aweijnitz/expressive-circuits-walkman-motor/assets/walkman_front-panel-deco-01.png

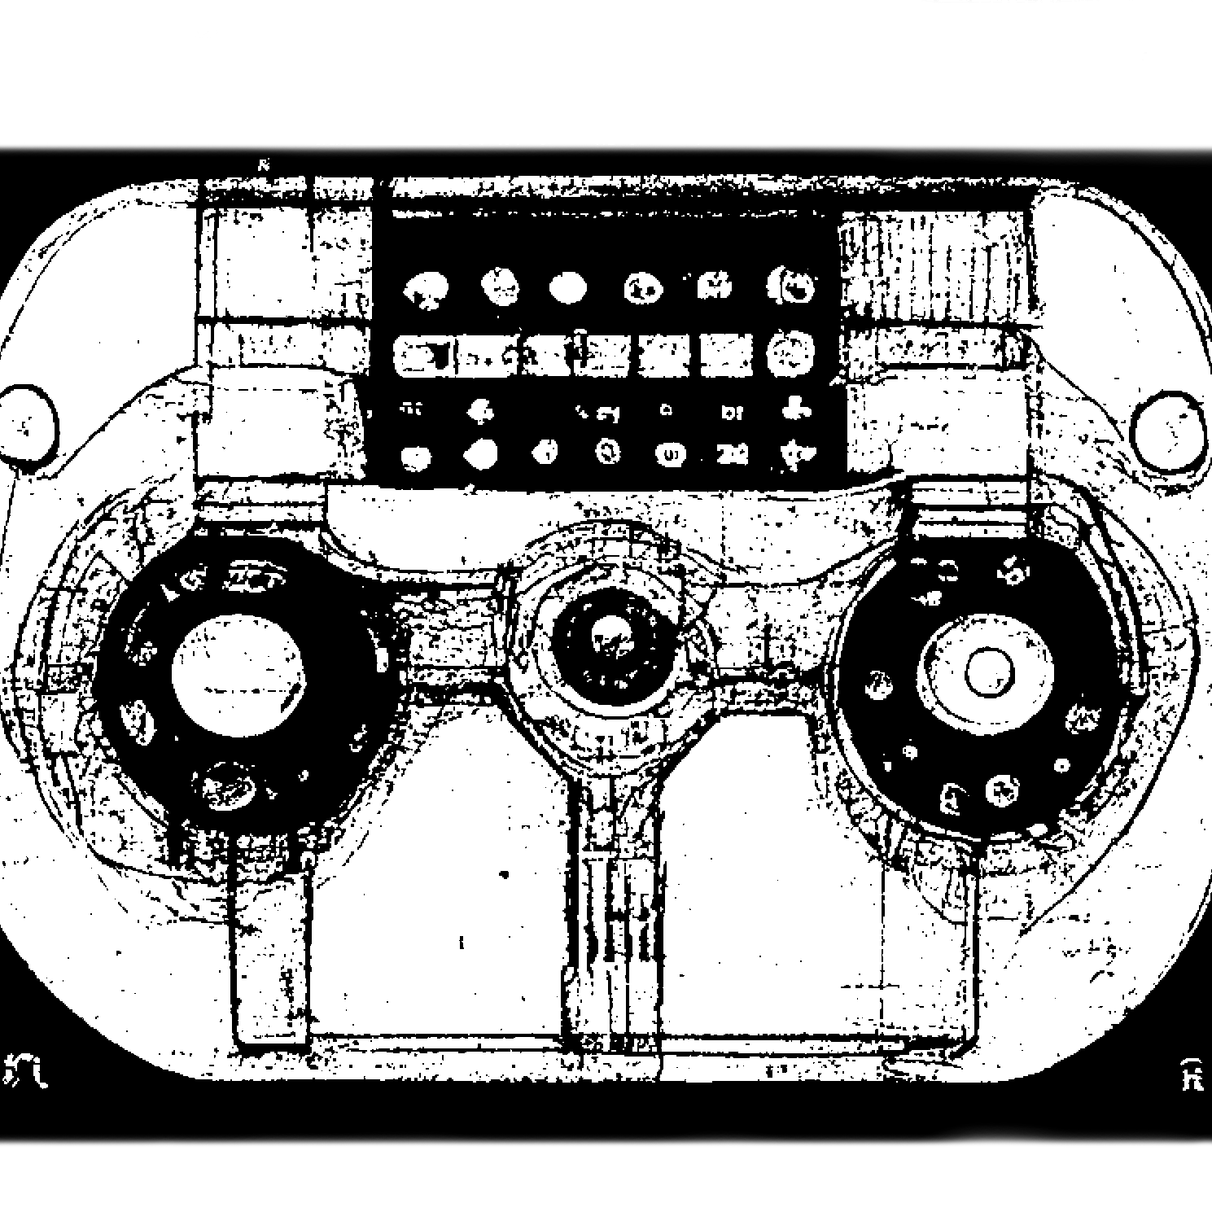
assets/walkman_front-panel-deco-01.png
