aweijnitz/expressive-circuits-walkman-motor/assets/walkman_front-panel-deco-MidJourney-export.png

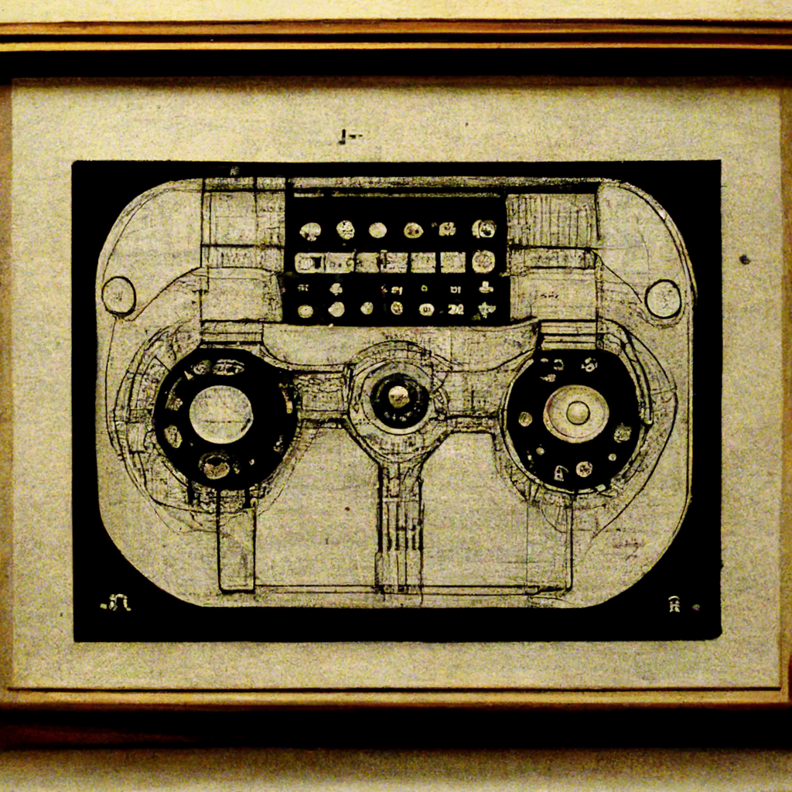
assets/walkman_front-panel-deco-MidJourney-export.png
