aweijnitz/expressive-circuits-walkman-motor/easyEDA-files/Schematic_WalkmanMotorModule_2022-08-23.pdf

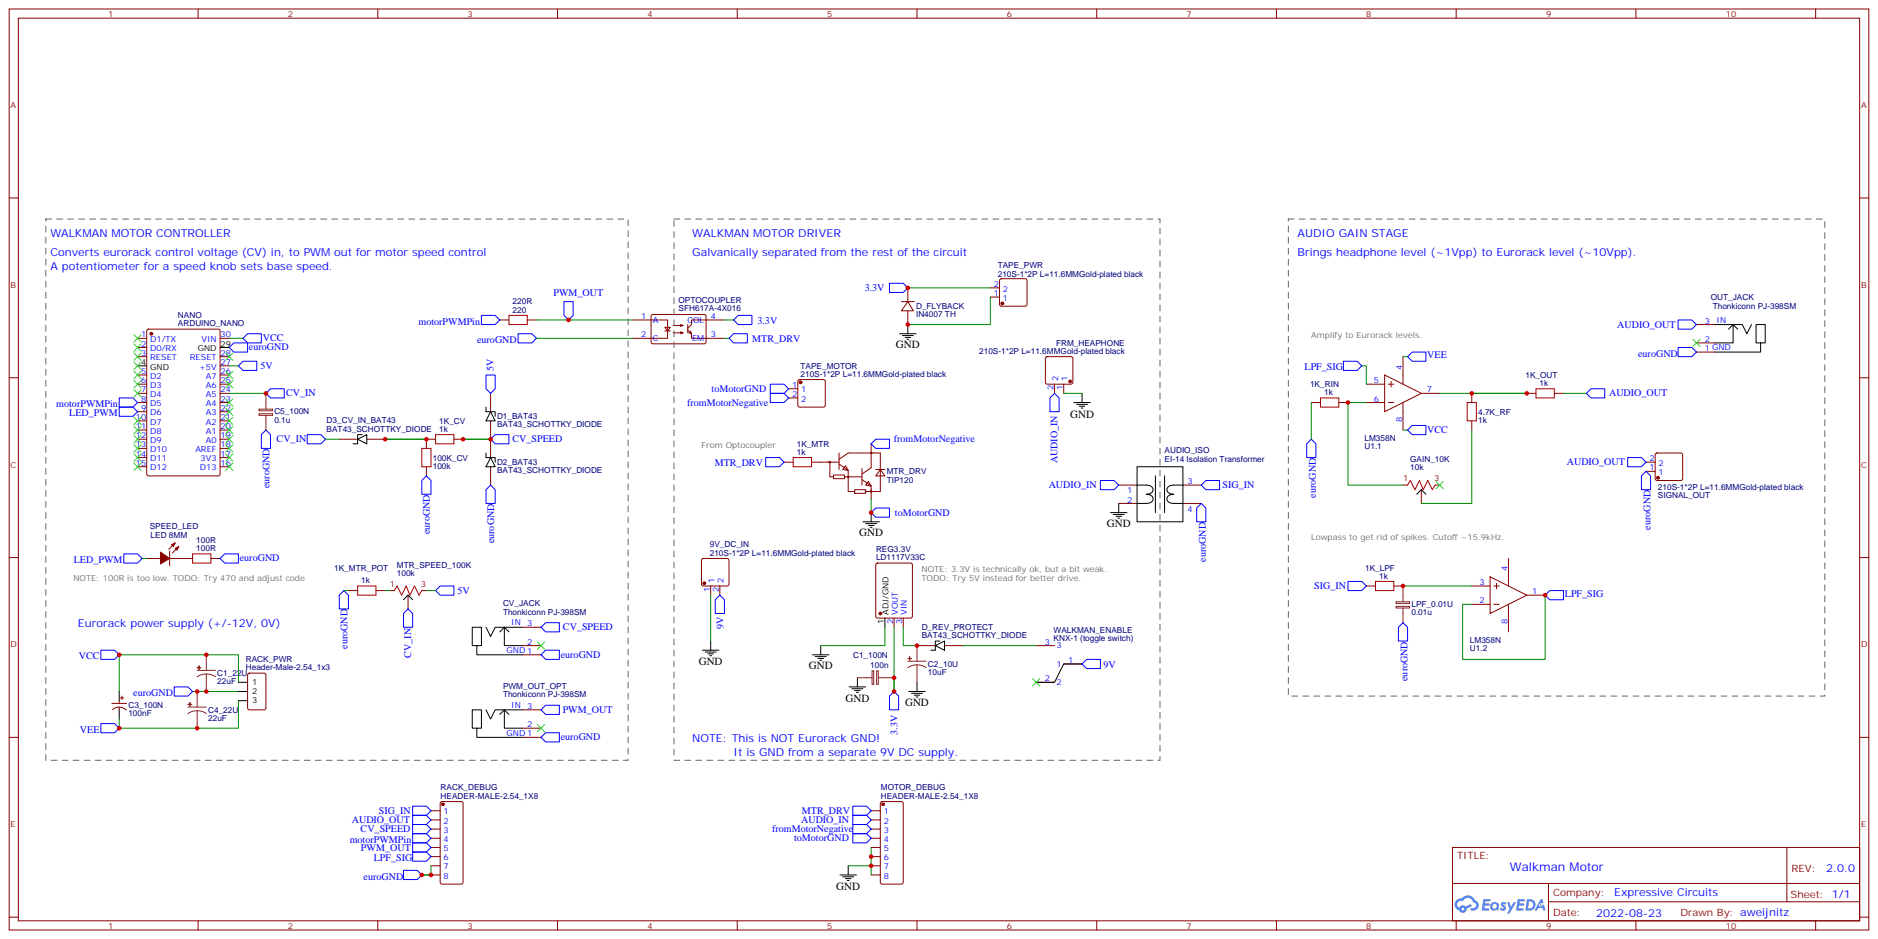
[picture p8: page 1]

WALKMAN MOTOR CONTROLLER
Converts eurorack control voltage (CV) in, to PWM out for motor speed control
A potentiometer for a speed knob sets base speed.

WALKMAN MOTOR DRIVER
Galvanically separated from the rest of the circuit

AUDIO GAIN STAGE
Brings headphone level (~1Vpp) to Eurorack level (~10Vpp).

Amplify to Eurorack levels.

Lowpass to get rid of spikes. Cutoff ~15.9kHz.

LED_PWM
NOTE: 100R is too low. TODO: Try 470 and adjust code

NOTE: 3.3V is technically ok, but a bit weak.
TODO: Try 5V instead for better drive.

NOTE: This is NOT Eurorack GND!

It is GND from a separate 9V DC supply.
